Alexgichamba/lipo-based-power-supply/simulations/webench-ss-sim-boost.pdf

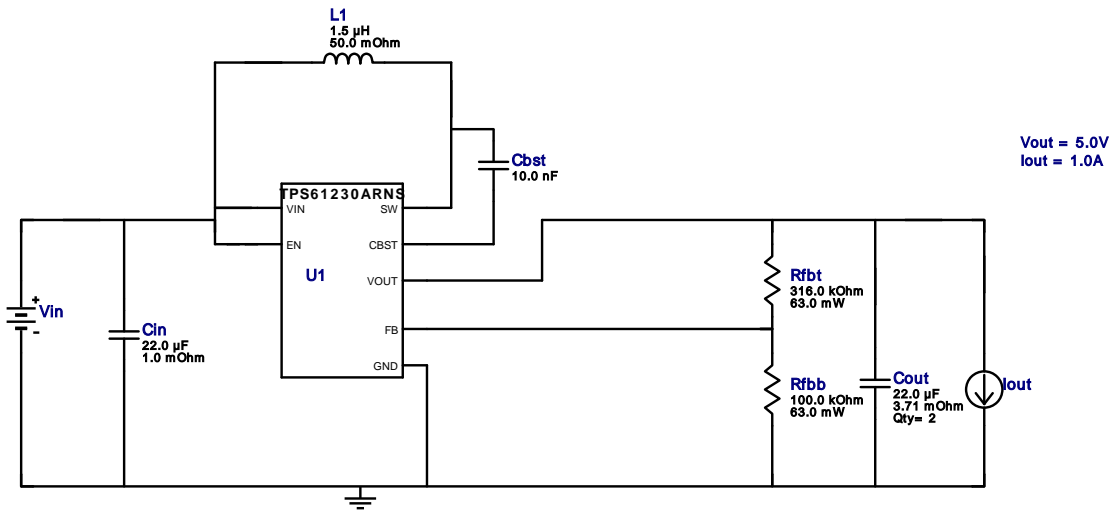
[picture p1: figure]
Vout = 5.0V; Cbst; Iout = 1.0A; L1 1.5 µH 50.0 m Ohm; TPS6 1 2 3 0 ARNS; CBST; VIN; GND; VOUT; Rfbt; 316.0 kOhm 63.0 m W; Rfbb 100.0 kOhm 63.0 m W; Cin 22.0 µF 1.0 m Ohm; Cout 22.0 µF 3.71 m Ohm Qty= 2; Vin; Iout

Copyright © 2022, Texas Instruments Incorporated | 1 | ti.com/webench

WEBENCH®
Design Report TPS61230ARNSR : TPS61230ARNSR 3.5V-4.2V to 5.00V @ 1A February 6, 2022 07:34:02 GMT-06:00

## WEBENCH ® Design Report

Design : 8 TPS61230ARNSR
TPS61230ARNSR 3.5V-4.2V to 5.00V @ 1A

VinMin = 3.5V
VinMax = 4.2V
Vout = 5.0V
Iout = 1.0A

Device = TPS61230ARNSR
Topology = Boost
Created = 2022-02-06 02:40:25.972 BOM Cost = $1.08
BOM Count = 1
Total Pd = 0.37W

## Electrical BOM

Name | Manufacturer | Part Number | Properties | Qty Price | Footprint
Cbst | TDK | CGA4C2C0G1H103J060AA (https://product.tdk.com/en/search/capacitor/ceramic/mlcc/info?part%5Fno%3DCGA4C2C0G1H103J060AA) Series= C0G/NP0 | Cap= 10.0 nF VDC= 50.0 V IRMS= 0.0 A
1 | $0.06
| | | | | 0805 7 mm²
Cin | MuRata | GRM188R60J226MEA0D (http://search.murata.co.jp/Ceramy/image/img/A01X/G101/ENG/GRM188R60J226MEA0%2D01.pdf) Series= X5R | Cap= 22.0 uF ESR= 1.0 mOhm VDC= 6.3 V IRMS= 6.0 A
1 | $0.05
| | | | | 0603 5 mm²
Cout | TDK | C1608X5R1A226M080AC (https://product.tdk.com/en/search/capacitor/ceramic/mlcc/info?part%5Fno%3DC1608X5R1A226M080AC) Series= X5R

Cap= 22.0 uF
ESR= 3.71 mOhm
VDC= 10.0 V
IRMS= 2.69936 A

2 $0.12
0603 5 mm²
L1 | CUSTOM | CUSTOM | L= 1.5 µH 50.0 mOhm | 1 | $0.05

VLP8040 9 mm²
Rfbb | Vishay-Dale | CRCW0402100KFKED (http://www.vishay.com/docs/20035/dcrcwe3.pdf) Series= CRCW..e3 | Res= 100.0 kOhm Power= 63.0 mW Tolerance= 1.0% | 1 | $0.01
0402 3 mm²
Rfbt | Vishay-Dale | CRCW0402316KFKED (http://www.vishay.com/docs/20035/dcrcwe3.pdf) Series= CRCW..e3 | Res= 316.0 kOhm Power= 63.0 mW Tolerance= 1.0% | 1 | $0.01
0402 3 mm²
U1 | Texas Instruments | TPS61230ARNSR (http://www.ti.com/product/TPS61230A) | Switcher | 1 | $0.66
RNS0007A 9 mm²

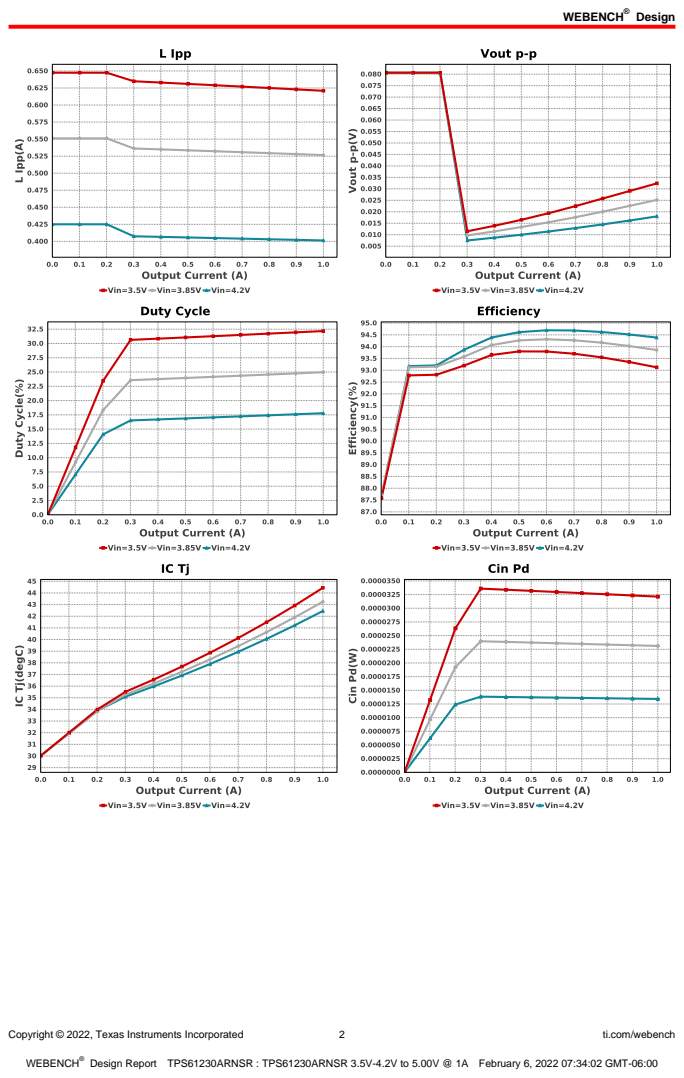
[picture p2: page 2]
Design; Copyright © 2022, Texas Instruments Incorporated; ti.com/webench

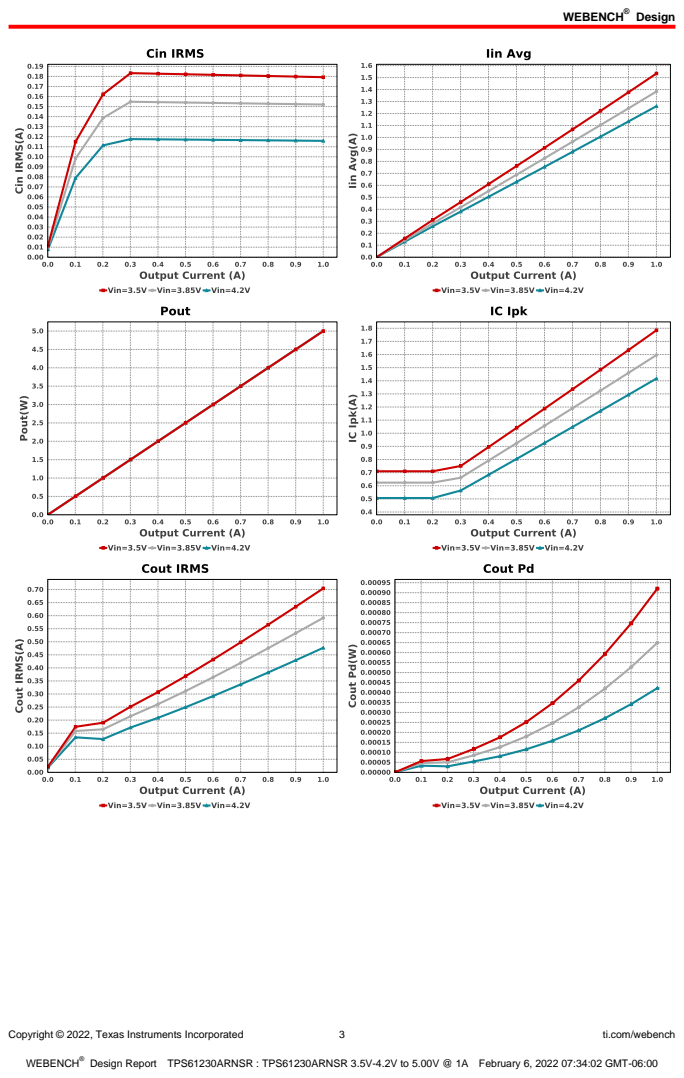
[picture p3: page 3]
Copyright © 2022, Texas Instruments Incorporated; ti.com/webench

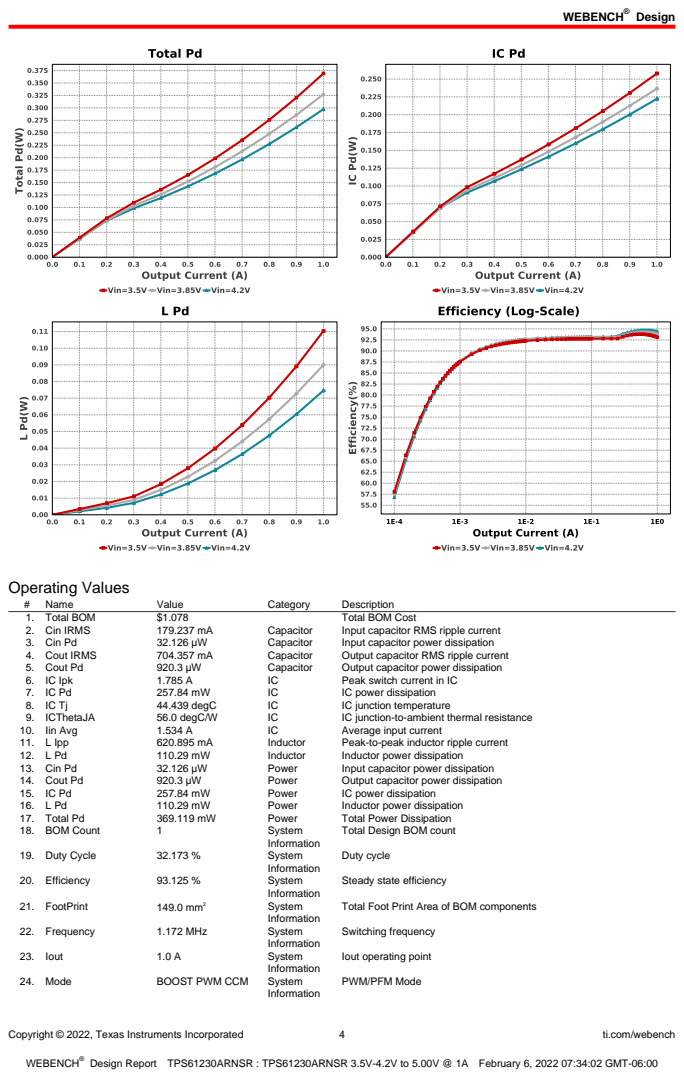
[picture p4: page 4]
Copyright © 2022, Texas Instruments Incorporated; ti.com/webench; Operating Values; Name; Value; Category; Description; 1. Total BOM; Total BOM Cost; 2. Cin IRMS; Capacitor; Input capacitor RMS ripple current; 3. Cin Pd; Input capacitor power dissipation; 4. Cout IRMS; Output capacitor RMS ripple current; 5. Cout Pd; Output capacitor power dissipation; 6. IC Ipk; Peak switch current in IC; IC power dissipation; 44.439 degC; IC junction temperature; 9. ICThetaJA; 56.0 degC/W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

Total Design BOM count

Steady state efficiency

Total Foot Print Area of BOM components

Iout operating point

PWM/PFM Mode

Copyright © 2022, Texas Instruments Incorporated | 5 | ti.com/webench
# | Name | Value | Category | Description

25. Pout | 5.0 W | System
| | | Information | Total output power
26. Vin | 3.5 V | System
| | | Information | Vin operating point
27. Vout Actual | 4.971 V | System
| | | Information | Vout Actual calculated based on selected voltage divider resistors
28. Vout Tolerance | 1.255 % | System
| | | Information | Vout Tolerance based on IC Tolerance (no load) and voltage divider resistors if applicable
29. Vout p-p | 32.389 mV | System
| | | Information | Peak-to-peak output ripple voltage

## Design Inputs

Name | Value | Description
Iout | 1.0 | Maximum Output Current
VinMax | 4.2 | Maximum input voltage
VinMin | 3.5 | Minimum input voltage
Vout | 5.0 | Output Voltage
| base_pn | | TPS61230A | Base Product Number
source | DC | Input Source Type
Ta | 30.0 | Ambient temperature


Copyright © 2022, Texas Instruments Incorporated | 6 | ti.com/webench

## Assembly

## Component Testing

Some published data on components in datasheets such as Capacitor ESR and Inductor DC resistance is based on conservative values that will guarantee that the components always exceed the specification. For design purposes it is usually better to work with typical values. Since this data is not always available it is a good practice to measure the Capacitance and ESR values of Cin and Cout, and the inductance and DC resistance of L1 before assembly of the board. Any large discrepancies in values should be electrically simulated in WEBENCH to check for instabilities and thermally simulated in WebTHERM to make sure critical temperatures are not exceeded.

## Soldering Component to Board

If board assembly is done in house it is best to tack down one terminal of a component on the board then solder the other terminal. For surface mount parts with large tabs, such as the DPAK, the tab on the back of the package should be pre-tinned with solder, then tacked into place by one of the pins. To solder the tab town to the board place the iron down on the board while resting against the tab, heating both surfaces simultaneously. Apply light pressure to the top of the plastic case until the solder flows around the part and the part is flush with the PCB. If the solder is not flowing around the board you may need a higher wattage iron (generally 25W to 30W is enough).

## Initial Startup of Circuit

It is best to initially power up the board by setting the input supply voltage to the lowest operating input voltage 3.5V and set the input supply's current limit to zero. With the input supply off connect up the input supply to Vin and GND. Connect a digital volt meter and a load if needed to set the minimum Iout of the design from Vout and GND. Turn on the input supply and slowly turn up the current limit on the input supply. If the voltage starts to rise on the input supply continue increasing the input supply current limit while watching the output voltage. If the current increases on the input supply, but the voltage remains near zero, then there may be a short or a component misplaced on the board. Power down the board and visually inspect for solder bridges and recheck the diode and capacitor polarities. Once the power supply circuit is operational then more extensive testing may include full load testing, transient load and line tests to compare with simulation results.

## Load Testing

The setup is the same as the initial startup, except that an additional digital voltmeter is connected between Vin and GND, a load is connected between Vout and GND and a current meter is connected in series between Vout and the load. The load must be able to handle at least rated output power + 50% ( 7.5 watts for this design). Ideally the load is supplied in the form of a variable load test unit. It can also be done in the form of suitably large power resistors. When using an oscilloscope to measure waveforms on the prototype board, the ground leads of the oscilloscope probes should be as short as possible and the area of the loop formed by the ground lead should be kept to a minimum. This will help reduce ground lead inductance and eliminate EMI noise that is not actually present in the circuit.

## WEBENCH® Electrical Simulation Report

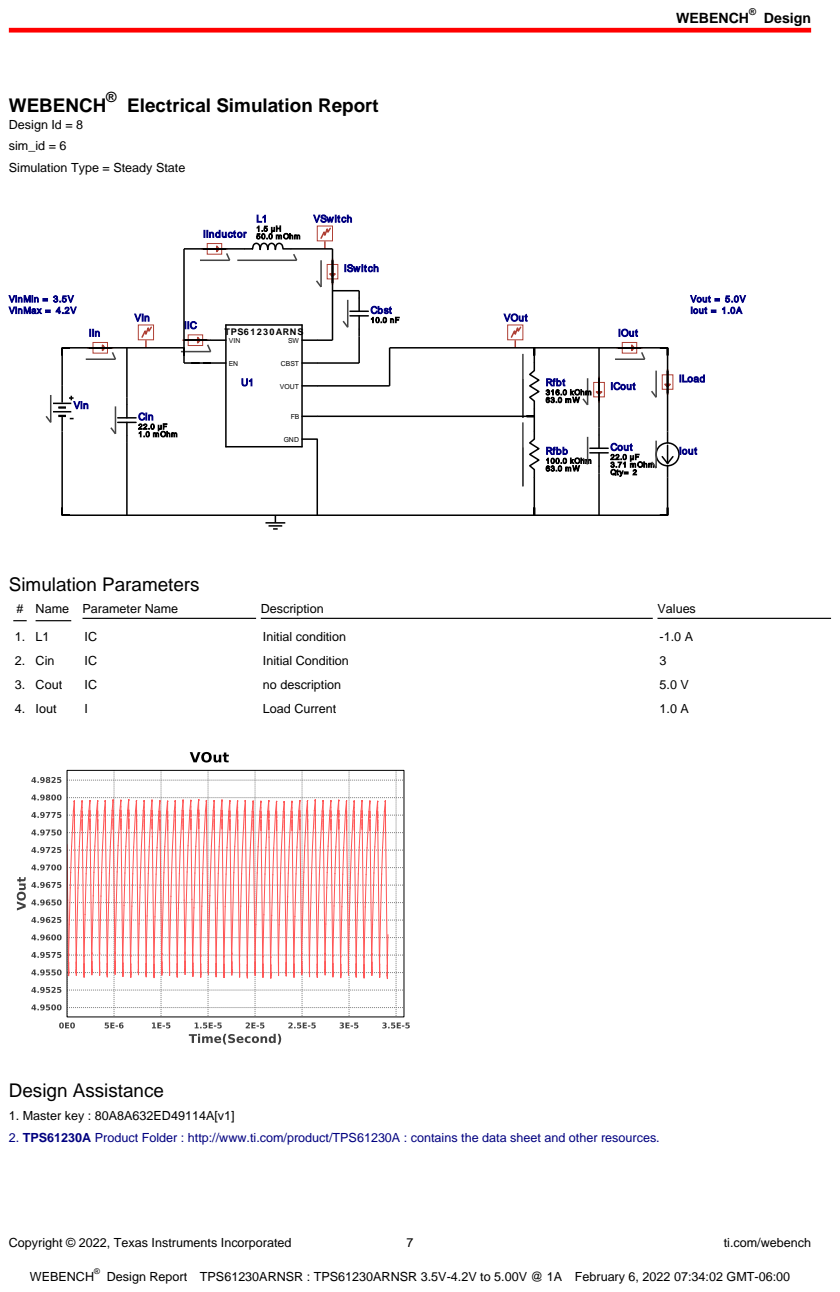
[picture p6: page 7]
Copyright © 2022, Texas Instruments Incorporated; ti.com/webench; Vout = 5.0V Iout = 1.0A VOut; ICout; VSwitch; IIC; Cbst 10.0 nF; VinMin = 3.5V; VinMax = 4.2V; VIn; L1 1.5 µH 50.0 m Ohm; IOut; ISwitch; TPS6 1 2 3 0 ARNS; CBST; VIN; GND; VOUT; Rfbt; 316.0 kOhm 63.0 m W; Rfbb 100.0 kOhm 63.0 m W; Cin 22.0 µF 1.0 m Ohm; IIn; Cout 22.0 µF 3.71 m Ohm Qty= 2; IInductor; Vin; ILoad; Iout; Simulation Parameters; # Name Parameter Name; Description; Values; Initial condition; 2. Cin; Initial Condition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

Design Id = 8
sim_id = 6
Simulation Type = Steady State

1. Master key : 80A8A632ED49114A[v1]
2. TPS61230A Product Folder : http://www.ti.com/product/TPS61230A : contains the data sheet and other resources.

Copyright © 2022, Texas Instruments Incorporated | 8 | ti.com/webench

Important Notice and Disclaimer

TI provides technical and reliability data (including datasheets), design resources (including reference designs), application or other design advice, web tools, safety information, and other resources AS IS and with all faults, and disclaims all warranties. These resources are intended for skilled developers designing with TI products. You are solely responsible for (1) selecting the appropriate TI products for your application, (2) designing, validating and testing your application, and (3) ensuring your application meets applicable standards, and any other safety, security, or other requirements.

These resources are subject to change without notice. TI grants you permission to use these resources only for development of an application that uses the TI products described in the resource. Other reproduction and display of these resources is prohibited. No license is granted to any other TI intellectual property right or to any third party intellectual property right. TI disclaims responsibility for, and you will fully indemnify TI and its representatives against, any claims, damages, costs, losses, and liabilities arising out of your use of these resources.

Providing these resources does not expand or otherwise alter TI's applicable Terms of Sale or other applicable terms available either on ti.com or provided in conjunction with TI products.
