Alexgichamba/lipo-based-power-supply/dc-supply-schematic.pdf

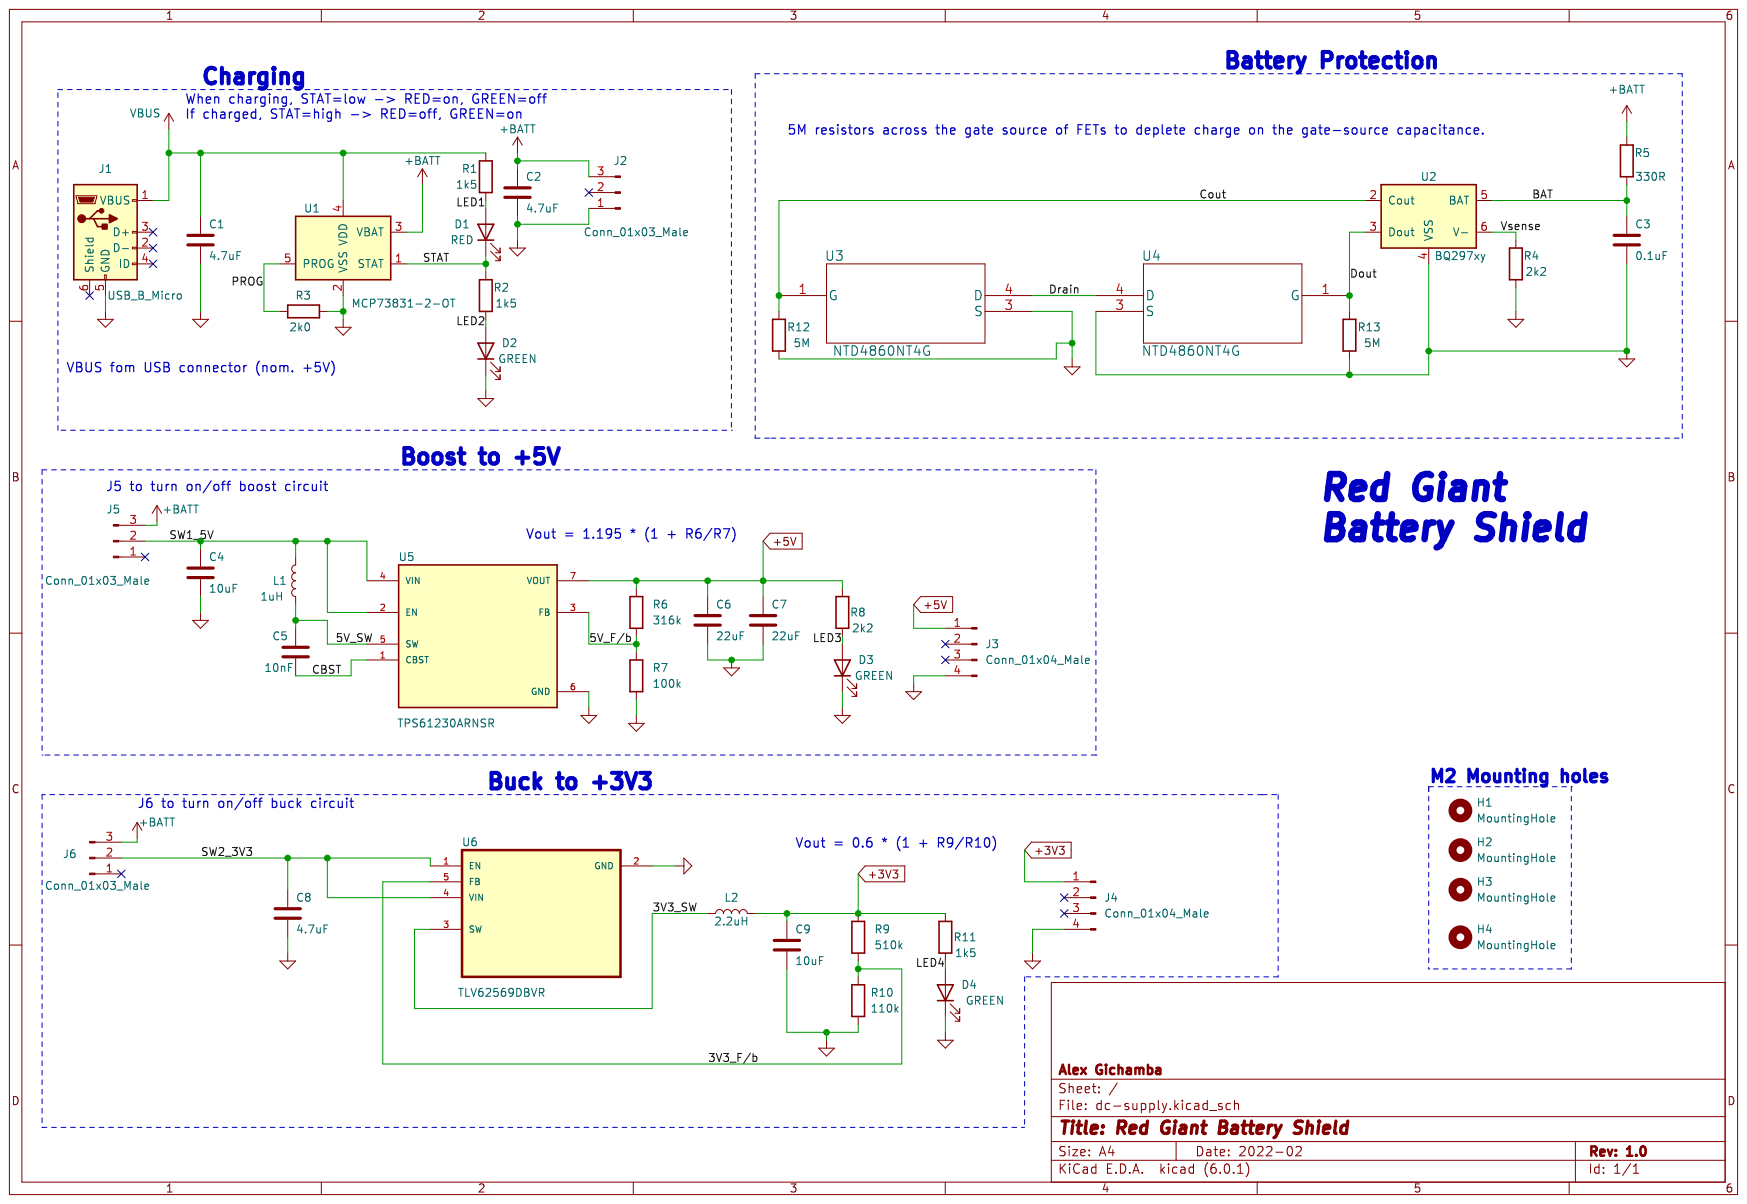
[picture p12: page 1]
