Alexgichamba/lipo-based-power-supply/dc-supply.kicad_pcb

## KiCad design dc-supply.kicad_pcb (2022-03-04)

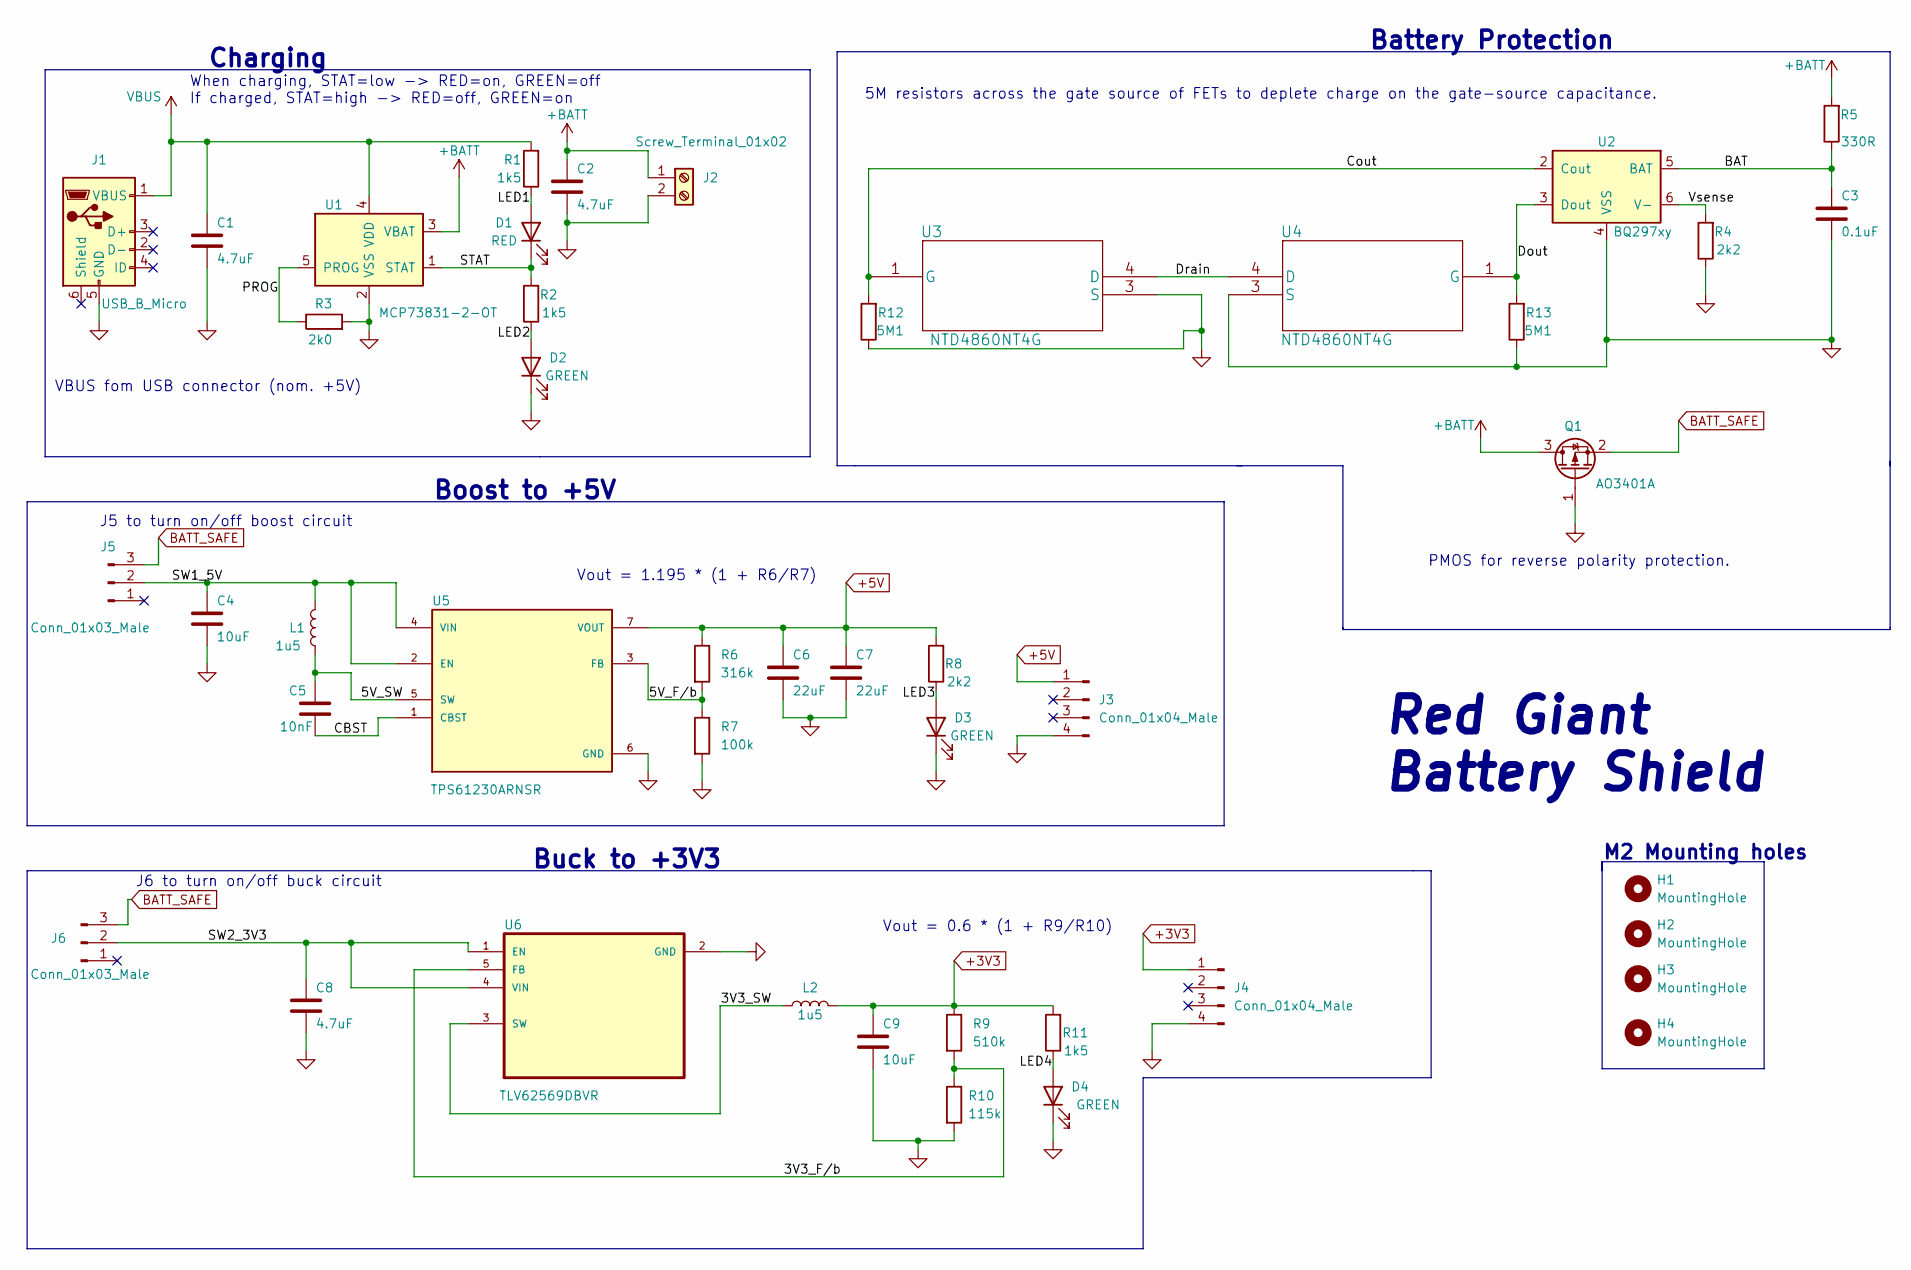
[picture p13: schematic dc-supply.kicad_sch, Red Giant Battery Shield]

Parts:
C1, C2: 4.7uF; C_0603_1608Metric
C3: 0.1uF; C_0402_1005Metric
C4, C9: 10uF; C_0805_2012Metric
C5: 10nF; C_0603_1608Metric
C6, C7: 22uF; C_0805_2012Metric
C8: 4.7uF; C_0805_2012Metric
D1: RED; LED_0603_1608Metric
D2, D3, D4: GREEN; LED_0603_1608Metric
H1, H2, H3, H4: MountingHole; MountingHole_2.2mm_M2
J1: USB_B_Micro; USB_Micro-B_Wuerth_629105150521
J2: Screw_Terminal_01x02; TerminalBlock_bornier-2_P5.08mm
J3, J4: Conn_01x04_Male; PinHeader_1x04_P2.54mm_Vertical
J5, J6: Conn_01x03_Male; PinHeader_1x03_P2.54mm_Vertical
L1, L2: 1u5; SWPA3015S1R5NT
Q1: AO3401A; SOT-23
R1, R2, R11: 1k5; R_0402_1005Metric
R3: 2k0; R_0402_1005Metric
R4, R8: 2k2; R_0402_1005Metric
R5: 330R; R_0805_2012Metric
R6: 316k; R_0603_1608Metric
R7: 100k; R_0603_1608Metric
R9: 510k; R_0603_1608Metric
R10: 115k; R_0603_1608Metric
R12, R13: 5M1; R_0603_1608Metric
U1: MCP73831-2-OT; SOT-23-5
U2: BQ297xy; WSON-6_1.5x1.5mm_P0.5mm
U3, U4: NTD4860NT4G; DPAK229P990X238-4N
U5: TPS61230ARNSR; IC_TPS61230ARNSR; PARTREV B
U6: TLV62569DBVR; SOT95P280X145-5N

Connections:
+3V3: C9.1, J4.1, L2.2, R9.1, R11.2
+5V: C6.1, C7.1, J3.1, R6.1, R8.2, U5.7 (VOUT)
+BATT: C2.1, J2.1, Q1.3 (D), R5.2, U1.3 (VBAT)
/3V3_F/b: R9.2, R10.1, U6.5 (FB)
/3V3_SW: L2.1, U6.3 (SW)
/5V_F/b: R6.2, R7.1, U5.3 (FB)
/5V_SW: C5.1, L1.1, U5.5 (SW)
/BAT: C3.1, R5.1, U2.5 (BAT)
/CBST: C5.2, U5.1 (CBST)
/Cout: R12.2, U2.2 (Cout), U3.1 (G)
/Dout: R13.2, U2.3 (Dout), U4.1 (G)
/Drain: U3.4 (D), U4.4 (D)
/LED1: D1.2 (A), R1.1
/LED2: D2.2 (A), R2.1
/LED3: D3.2 (A), R8.1
/LED4: D4.2 (A), R11.1
/PROG: R3.1, U1.5 (PROG)
/STAT: D1.1 (K), R2.2, U1.1 (STAT)
/SW1_5V: C4.1, J5.2, L1.2, U5.2 (EN), U5.4 (VIN)
/SW2_3V3: C8.1, J6.2, U6.1 (EN), U6.4 (VIN)
/Vsense: R4.2, U2.6 (V-)
BATT_SAFE: J5.3, J6.3, Q1.2 (S)
GND: C1.2, C2.2, C3.2, C4.2, C6.2, C7.2, C8.2, C9.2, D2.1 (K), D3.1 (K), D4.1 (K), J1.5 (GND), J2.2, J3.4, J4.4, Q1.1 (G), R3.2, R4.1, R7.2, R10.2, R12.1, R13.1, U1.2 (VSS), U2.4 (VSS), U3.3 (S), U4.3 (S), U5.6 (GND), U6.2 (GND)
VBUS: C1.1, J1.1 (VBUS), R1.2, U1.4 (VDD)

Notes on the sheet:
M2 Mounting holes
Vout = 0.6 * (1 + R9/R10)
Vout = 1.195 * (1 + R6/R7)
PMOS for reverse polarity protection.
Buck to +3V3
J6 to turn on/off buck circuit
Battery Protection
Red Giant Battery Shield
VBUS fom USB connector (nom. +5V)
Boost to +5V
Charging
When charging, STAT=low -> RED=on, GREEN=off If charged, STAT=high -> RED=off, GREEN=on
5M resistors across the gate source of FETs to deplete charge on the gate-source capacitance.
J5 to turn on/off boost circuit

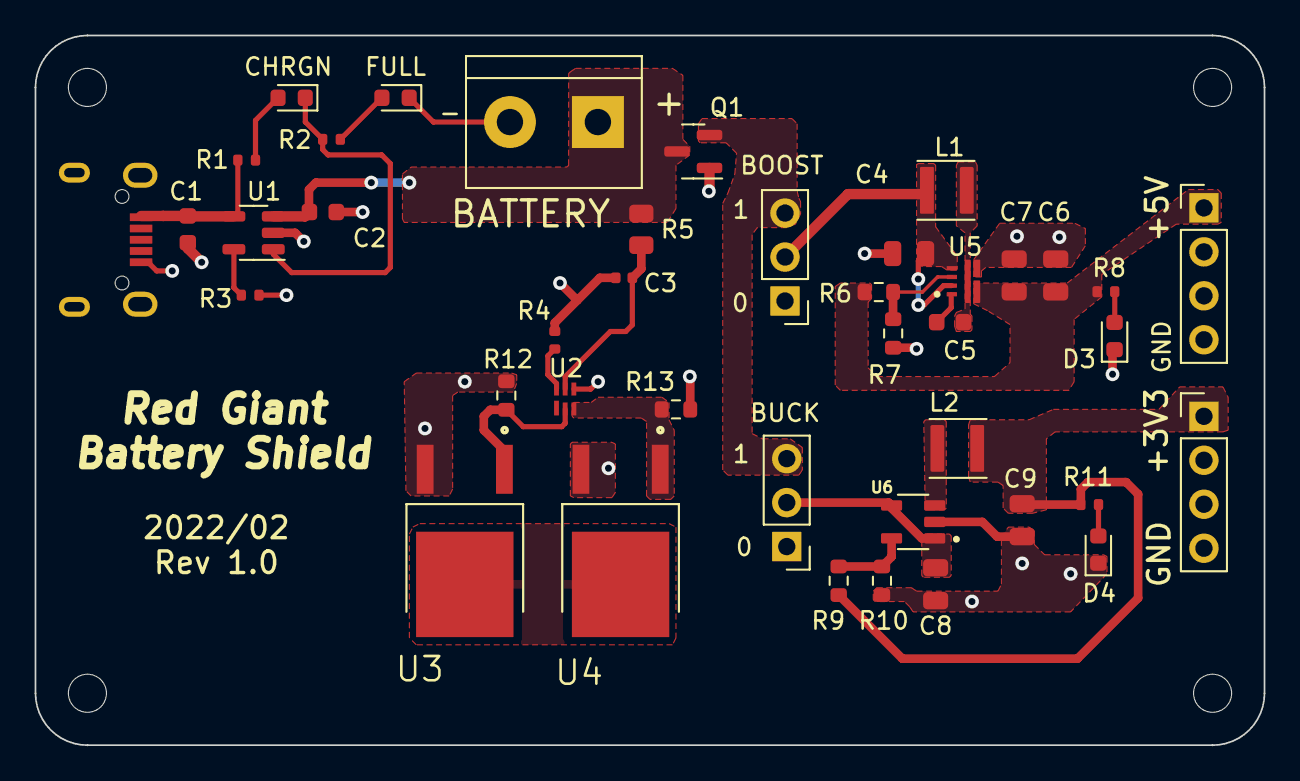
[picture p14: board dc-supply.kicad_pcb from above]

Board: 2 copper layers, 71.0 x 41.0 mm, 45 parts (0 on the bottom side), 24 nets.
